Losciale-Verdille/Robot-curieux/Rapports seances/Vivian/Seance13decembre/READ.md

Rapport 13/12/18:

Durant ces 3 heures, nous avons travaillé sur un prototype de microphone qui nous permetterait d 'entendre à une grrande distance. Nous avons reussi à créer le micro mais cependant la portée d'écoute était très faible ( il fallait être à 5 cm du micro). nous avons essayé d'amplifier pour capter des variations plus petites mais sans succès, j'ai essayé avec un transistor NPN afin d'amplifier le signal mais sans succès.

Ensuite, j'ai récupéré une base d'un projet et je l'ai démonté afin de récuperer les moteurs et les roues associées. J'ai fait quelques tests pour vérifier le bon fonctionnement de chaque moteurs puis nous avons établit notre cahier des charges ainsi que la repartition des taches ( je ne sais pas si il faut le mettre sur le github ou pas).

Possibilité de recherche niveau micro: conne autour du micro
niveau moteur: recuperer un boitier pour des piles ( 4x 1,5V je pense)
