Losciale-Verdille/Robot-curieux/Rapports seances/Vivian/Seance20 decembre/READ.md

Durant cette séance, je me suis principalement concentré sur les moteurs. 

Tout d'abord, j'ai crée la base de notre robot avec une planche de bois, fixé une roue folle, récuperé le matériel necéssaire pour le projet tel que l'écran, les capteurs de distances etc...

Concernant les moteurs, ce qui est assez bizarre est le fait que la puissance entre les 2 soient très grande, en effet il faut faire tourner un moteur a 80 ( sur 255 pwm) et l'autre a 150 pour que les 2 moteurs tournent à la même vitesse. Problème aussi au niveau de la roue gauche, le pneu était mal mis ce qui faisait dévier la trajectoire du robot, j'ai essayé de remettre le pneu sans succès jusqu'à que je change complètement de roue.

En soit la partie moteur n'est pas la plus longue et la plus dure, seulement pour continuer notre robot, il faut qu'on arrive à faire fonctionner le micro afin que je programme le robot pour qu'il se déplace en fonction du son. Mon collègue a trouvé une piste potentielle avec l'utilisation d'un cone, qui semble marche assez bien.

Des tests seront faits durant les vacances sur un mode automatique sans la fonction du son.
