Losciale-Verdille/Robot-curieux/Rapports seances/Images/20190311_132352.jpg

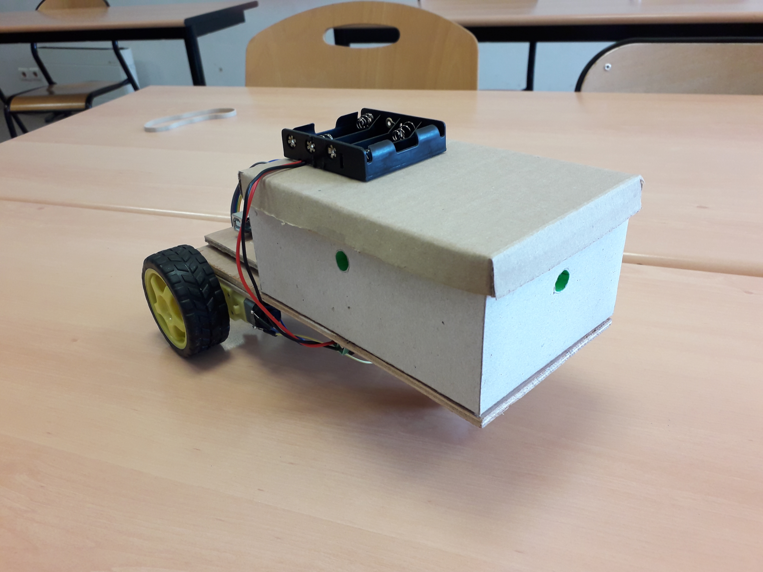
Rapports seances/Images/20190311_132352.jpg
