Losciale-Verdille/Robot-curieux/Rapports seances/Images/bt1.png

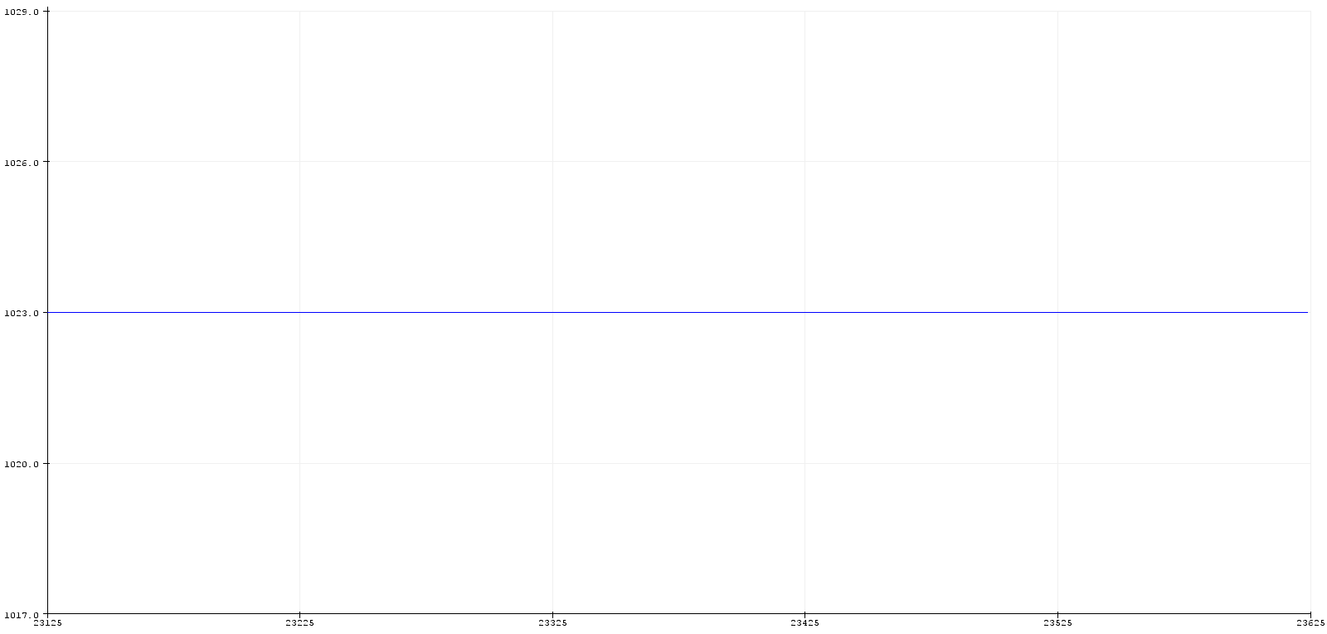
Rapports seances/Images/bt1.png
