Losciale-Verdille/Robot-curieux/Rapports seances/Images/bt2.png

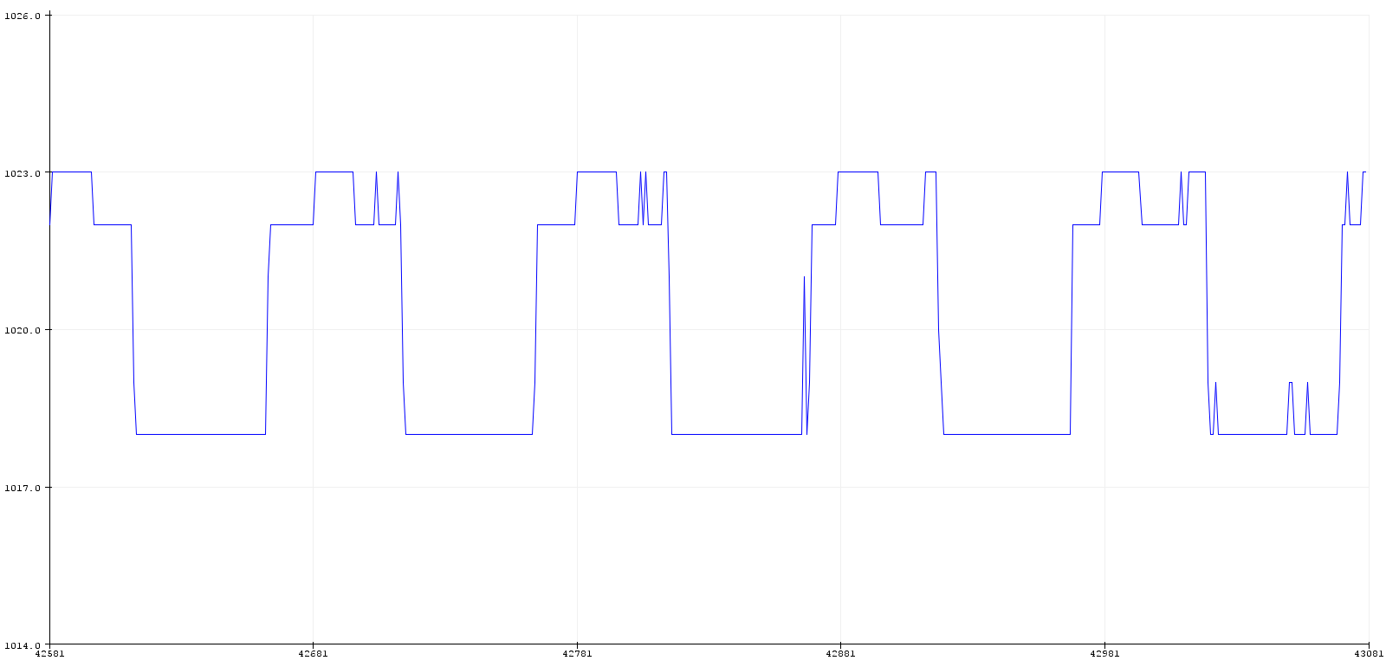
Rapports seances/Images/bt2.png
