Losciale-Verdille/Robot-curieux/Rapports seances/Images/bt3.png

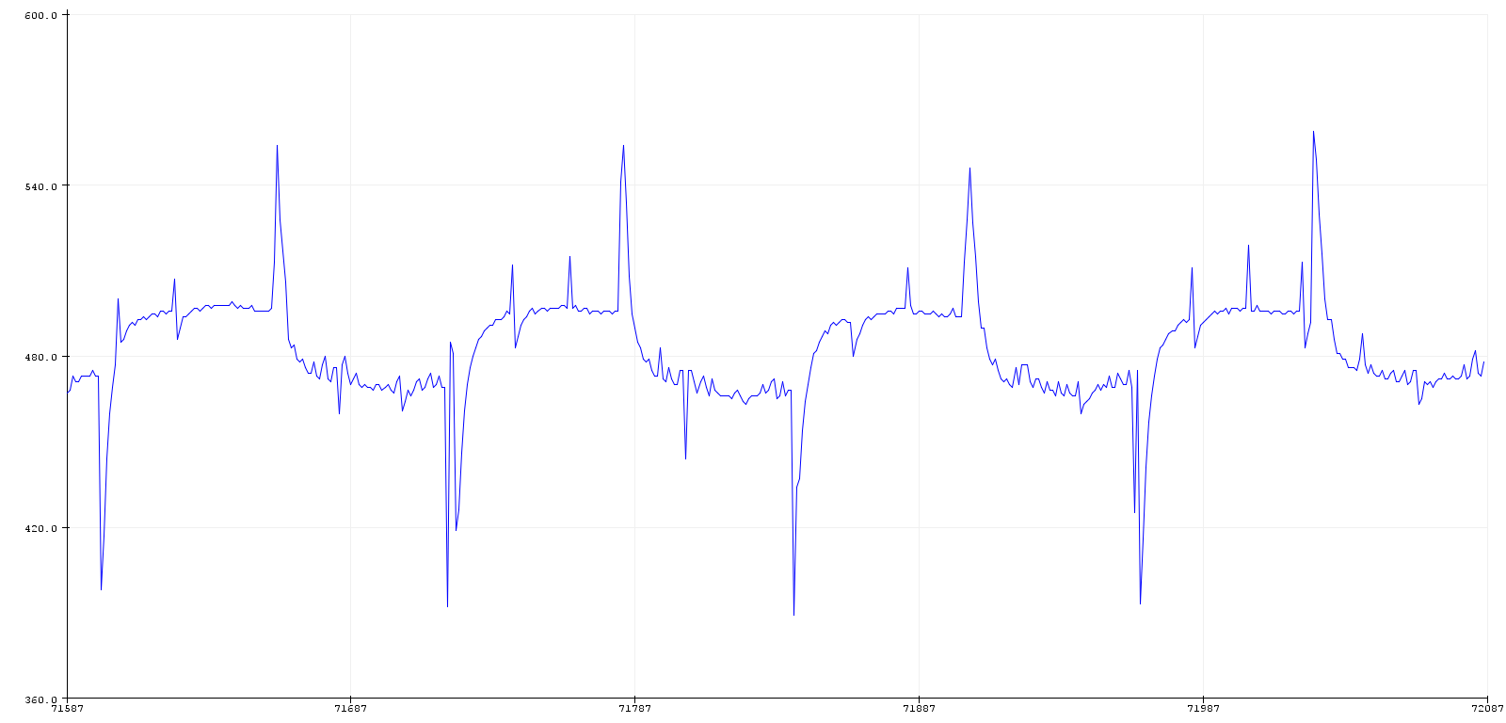
Rapports seances/Images/bt3.png
