Losciale-Verdille/Robot-curieux/Rapports seances/Vivian/Seance13decembre/mesure du micro.jpg

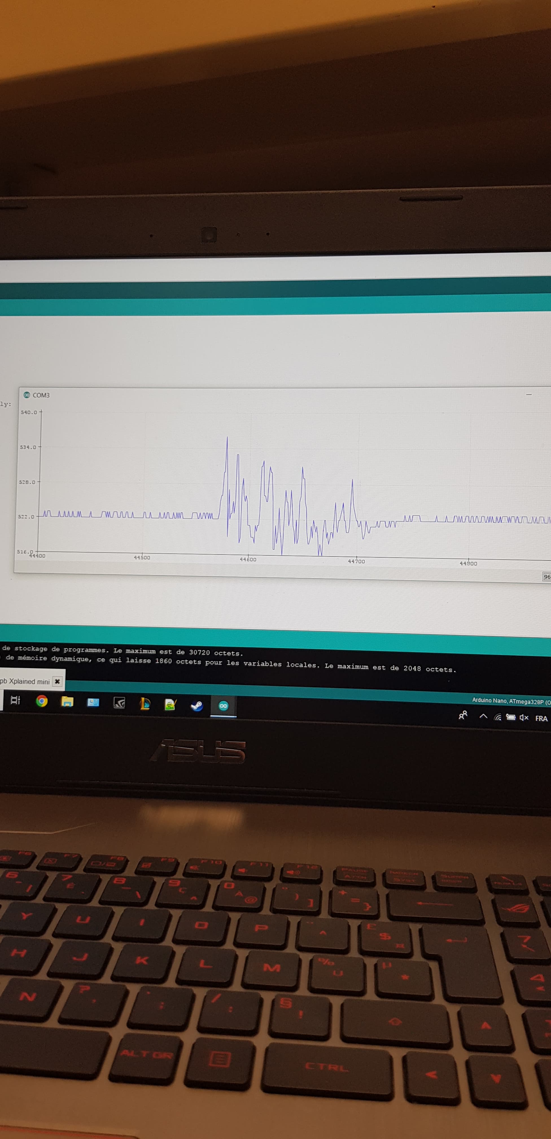
Rapports seances/Vivian/Seance13decembre/mesure du micro.jpg
