Losciale-Verdille/Robot-curieux/Rapports seances/Vivian/Seance13decembre/micro.jpg

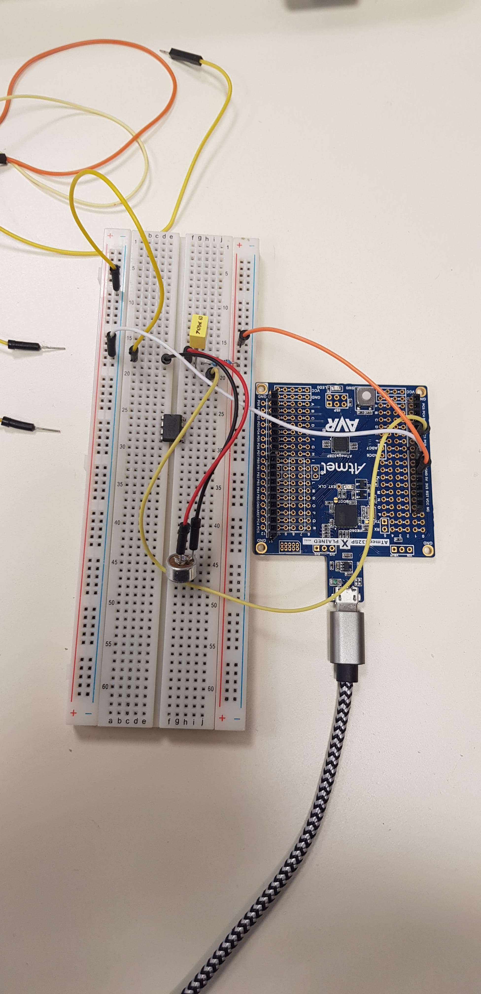
Rapports seances/Vivian/Seance13decembre/micro.jpg
