Losciale-Verdille/Robot-curieux/Rapports seances/Vivian/Seance13decembre/test de fonctionnement des roues et moteurs.jpg

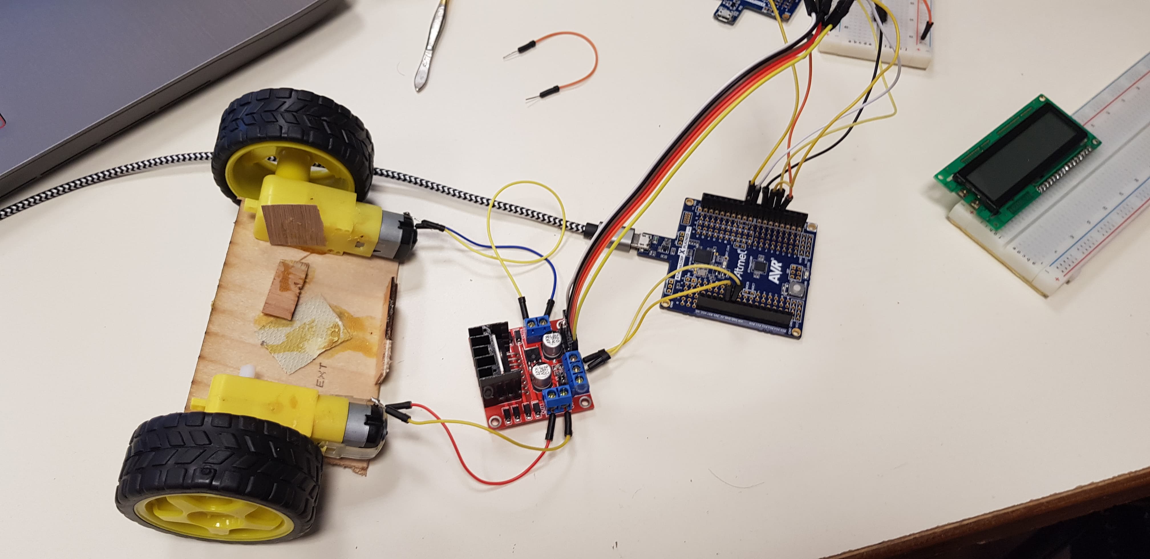
Rapports seances/Vivian/Seance13decembre/test de fonctionnement des roues et moteurs.jpg
